WhiteMuyi/Timelapse-Photogrammetry-Wireless-Sensing-Network/figure/23.jpg

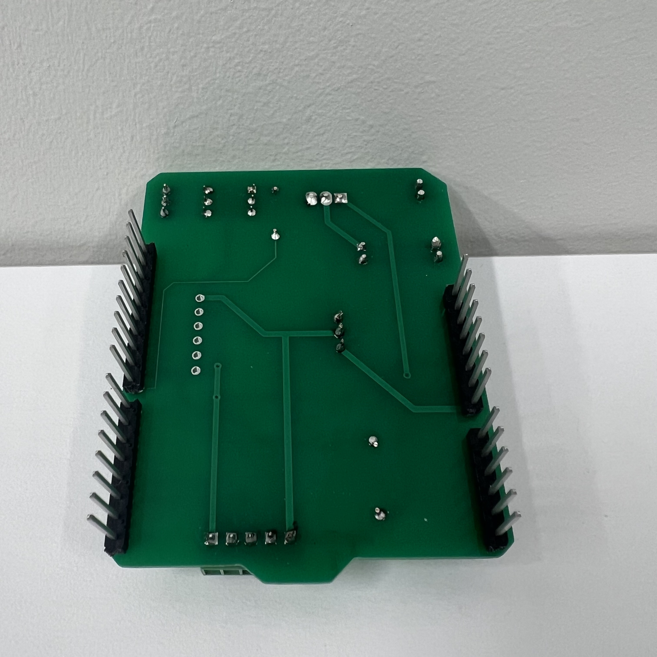
figure/23.jpg
