WhiteMuyi/Timelapse-Photogrammetry-Wireless-Sensing-Network/figure/27.jpg

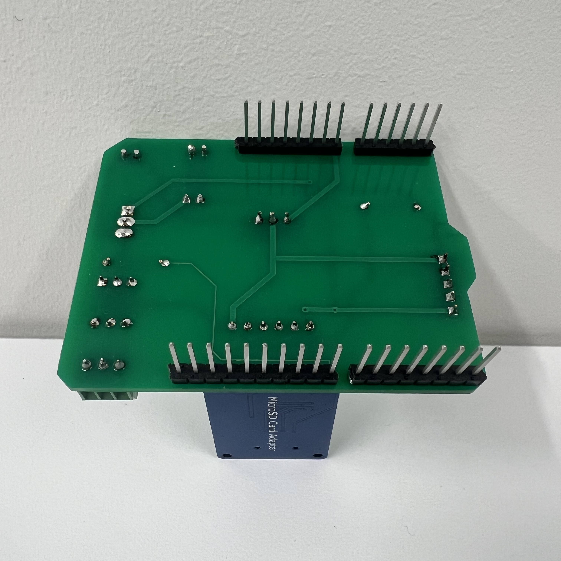
figure/27.jpg
