WhiteMuyi/Timelapse-Photogrammetry-Wireless-Sensing-Network/Tutorial/CaseInstall.md

### Inside & Outside Install:

Inside             |  Outside
:-------------------------:|:-------------------------:
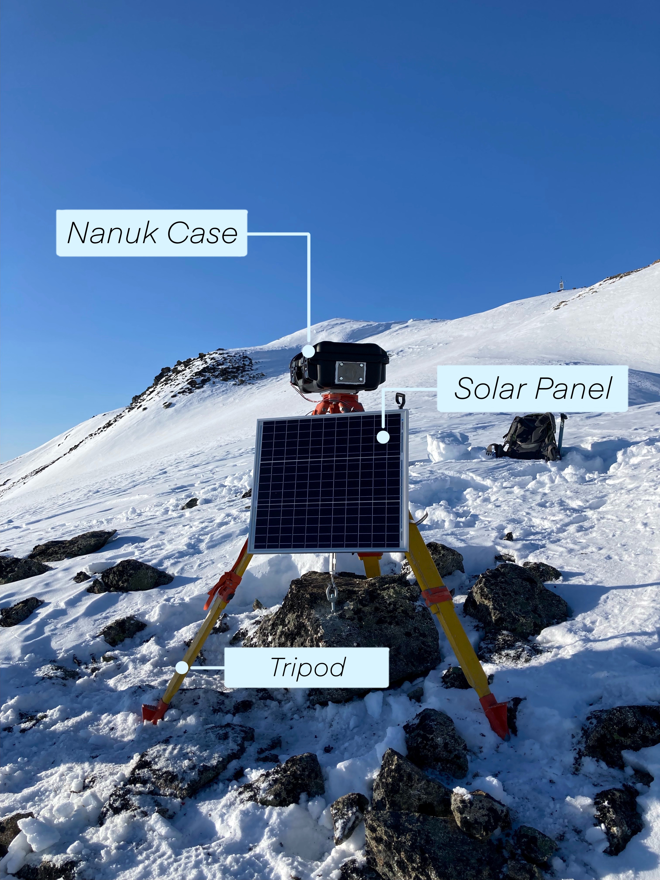
[picture p11: figure/Outside.jpg]
  |  

### Enclosure Detail:

Close-up of camera lens          |  Close-up of plexiglass      
:-------------------------:|:-------------------------:
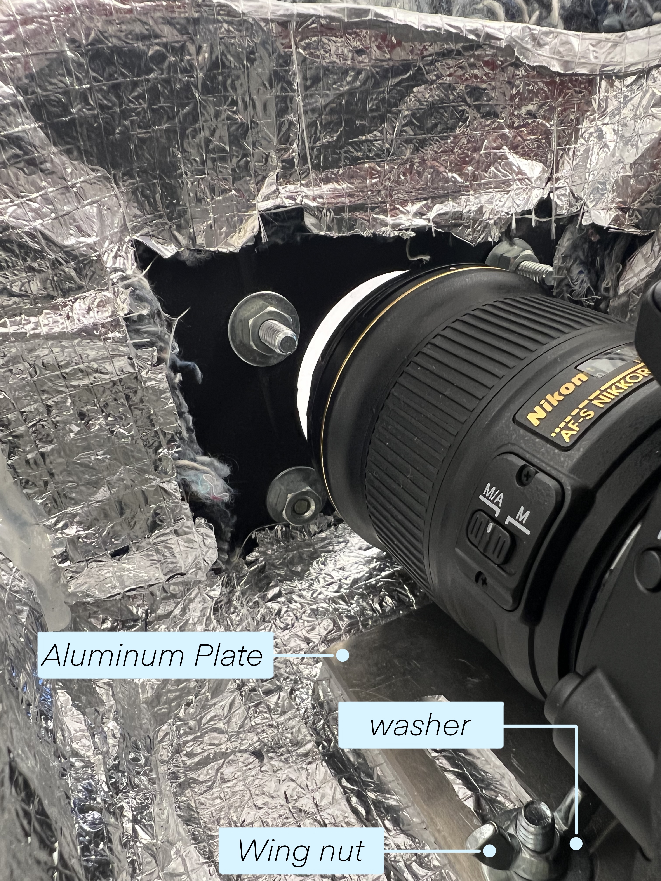
[picture p12: figure/Detail1.jpg]
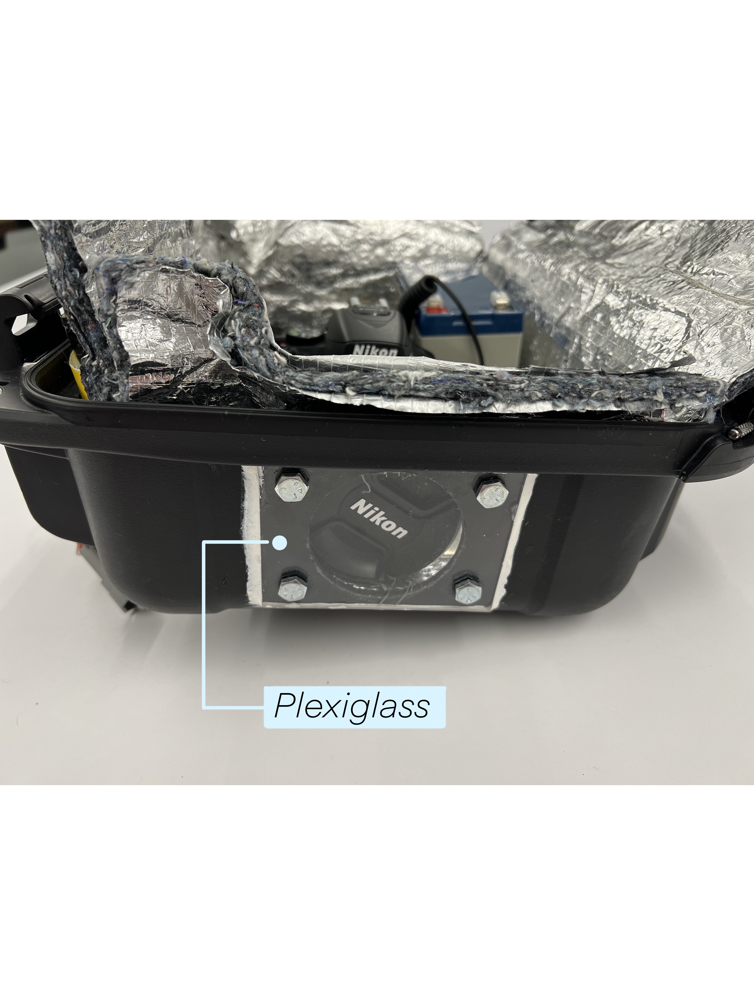
[picture p13: figure/Detail2.jpg]
  |  

Close-up of cable gland      |  Close-up of Miscellaneous
:-------------------------:|:-------------------------:
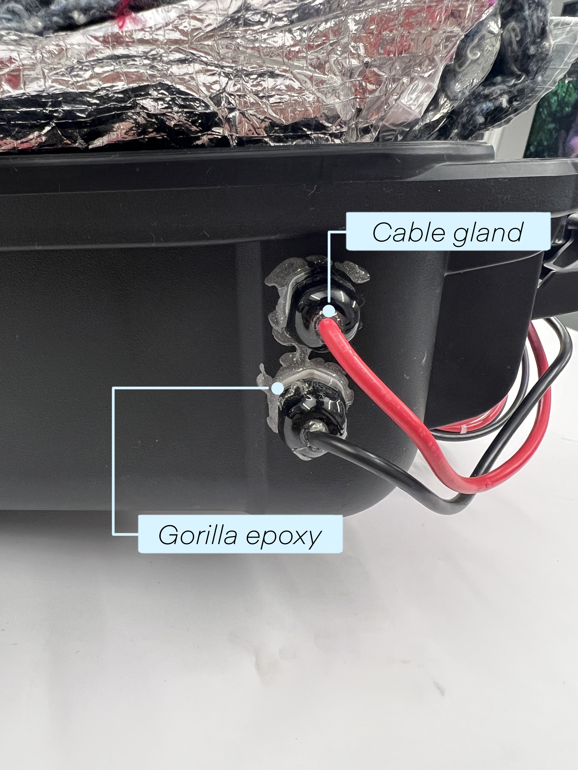
[picture p14: figure/Detail3.jpg]
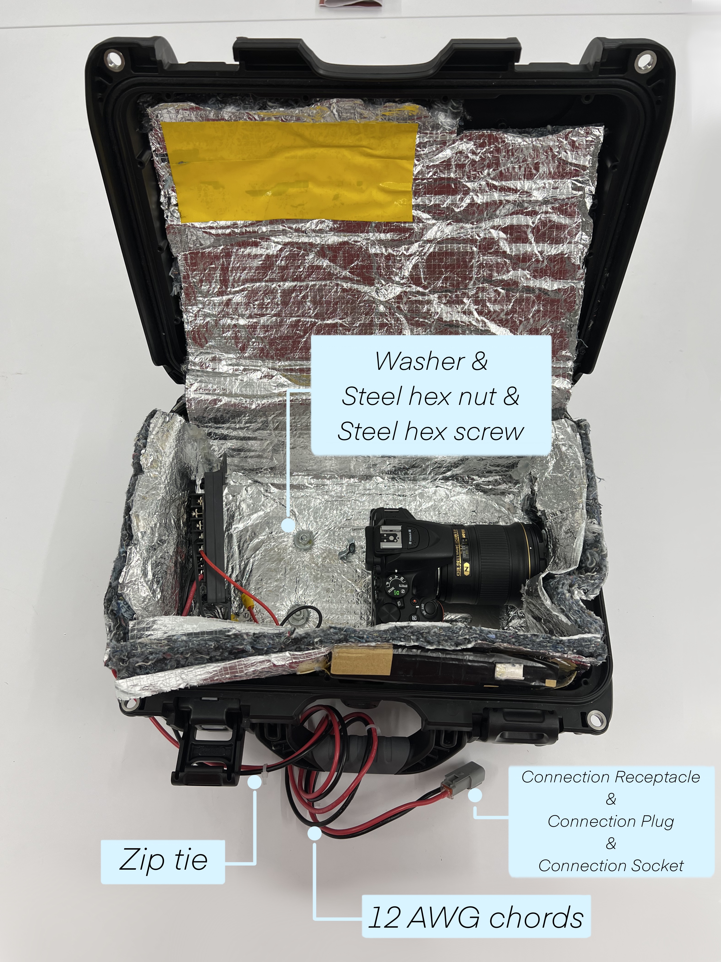
[picture p15: figure/Detail4.jpg]
|
