WhiteMuyi/Timelapse-Photogrammetry-Wireless-Sensing-Network/Tutorial/Step-by-Step.md

## Step-by-Step Soldering Tutorial

 The principle to be followed when soldering is to begin with the shorter components, followed by the taller ones.

### Step-1: 1kΩ resistance

Vertical             |  Bottom
:-------------------------:|:-------------------------:
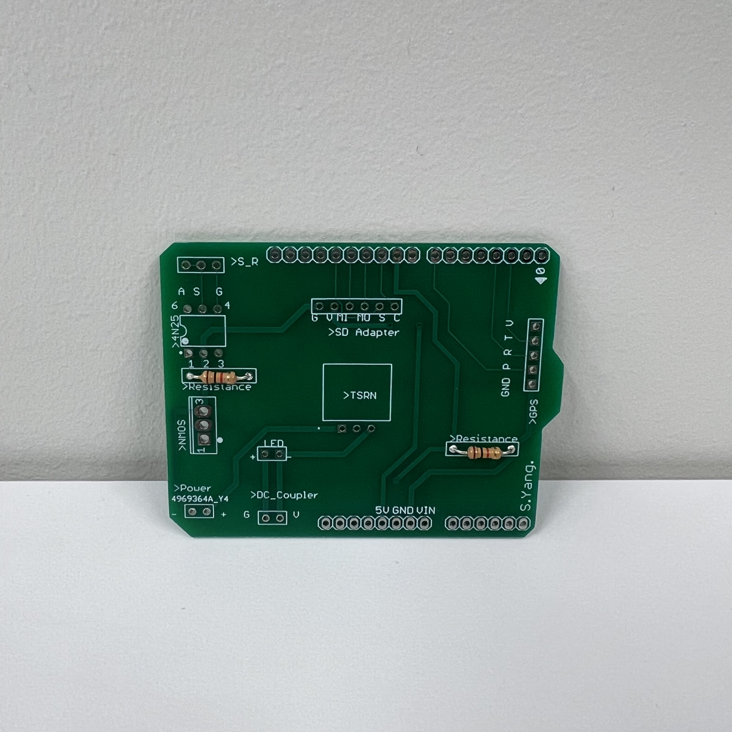
[picture p16: figure/1.jpg]
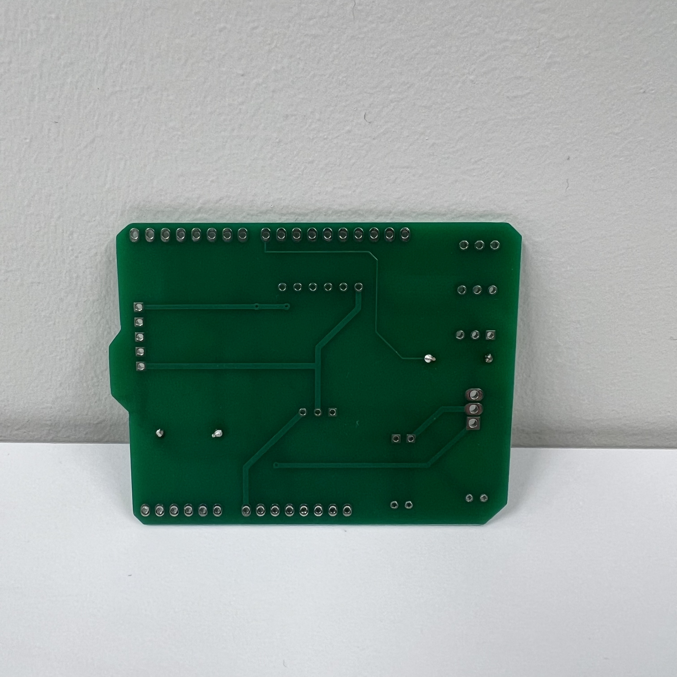
[picture p17: figure/2.jpg]
  |  

### Step-2: Optocoupler (4N25)

Vertical             |  Bottom
:-------------------------:|:-------------------------:
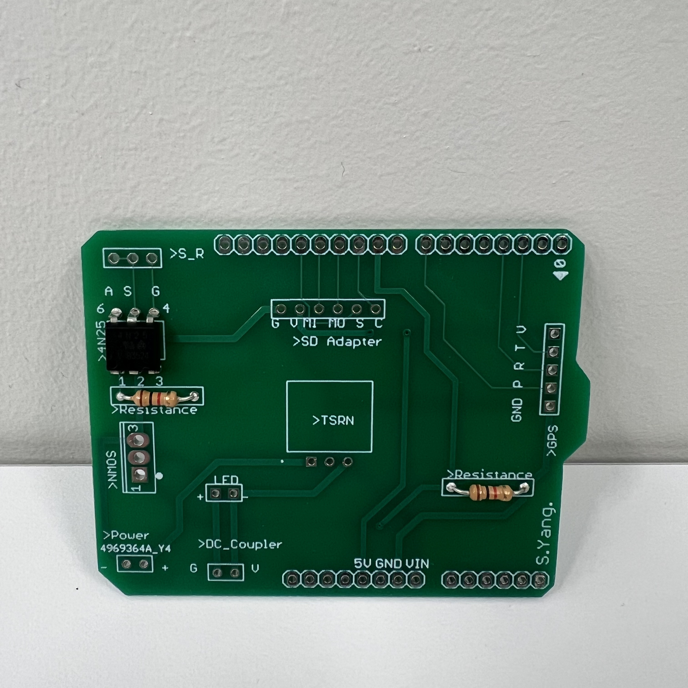
[picture p18: figure/3.jpg]
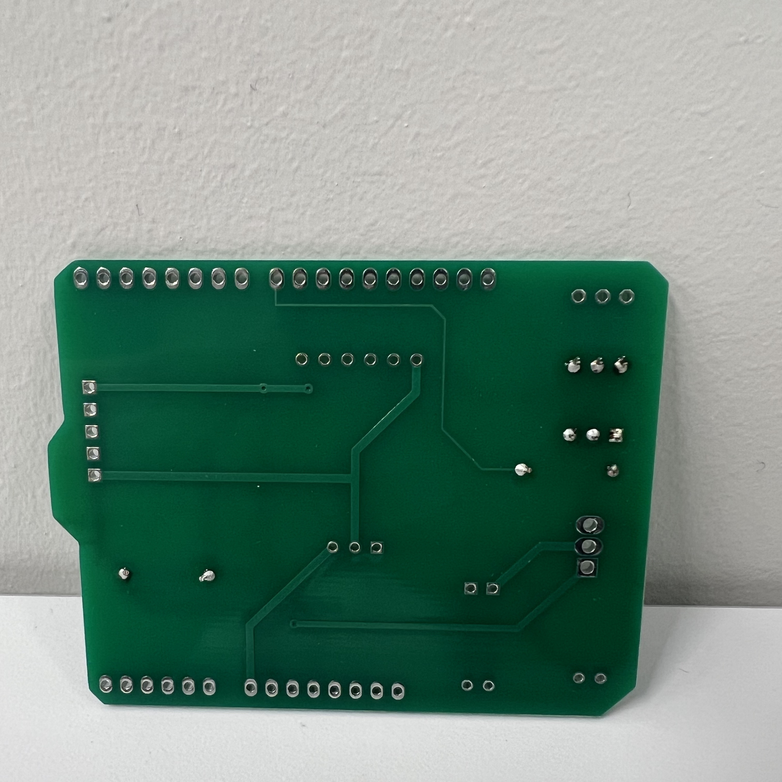
[picture p19: figure/4.jpg]
  |  

### Step-3: LED

Front             |  Vertical      |  Bottom
:-------------------------:|:-------------------------:|:-------------------------:
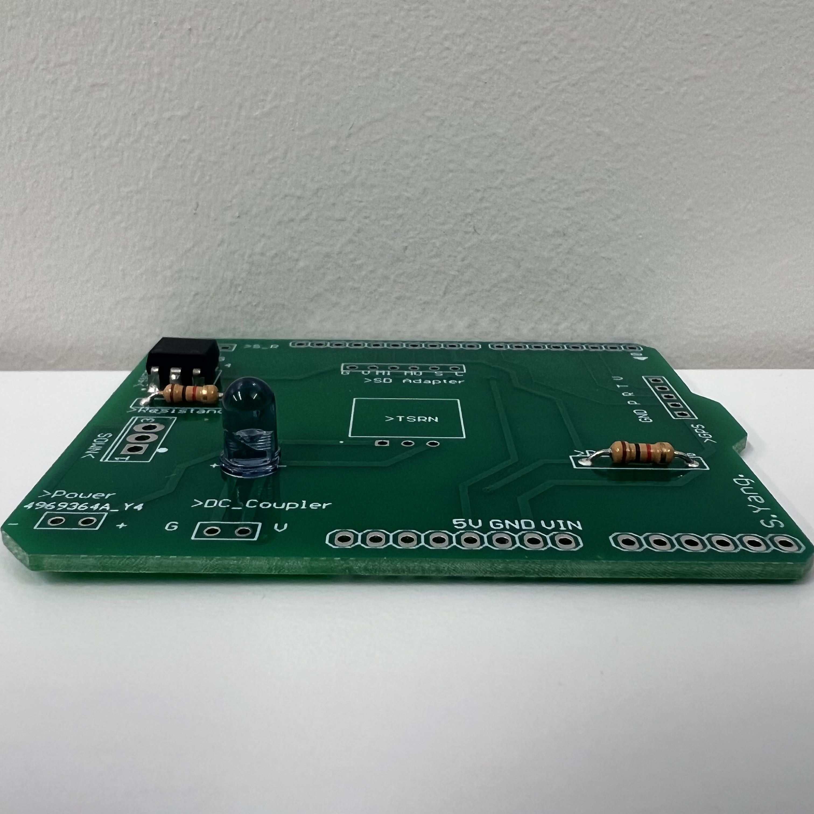
[picture p20: figure/5.jpg]
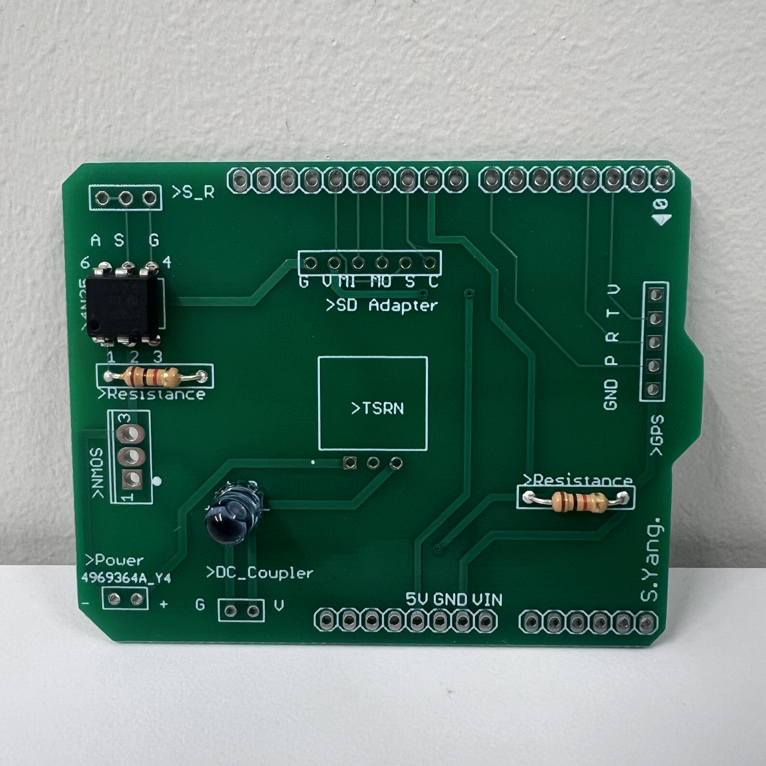
[picture p21: figure/6.jpg]
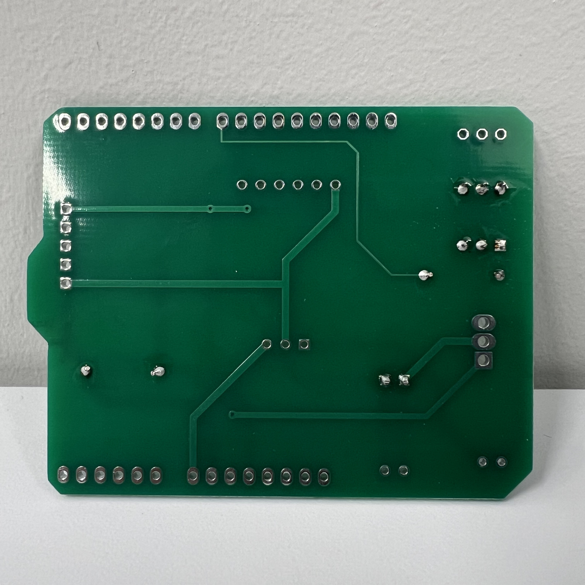
[picture p22: figure/7.jpg]
  |  |  

### Step-4: Terminal Block

3 x 2-pin terminal blocks and 2 x 3-pin terminal blocks are soldered in this step. 
The terminal blocks are for GPS, DC Coupler and Power.
The front of the terminal block should face outward towards the PCB.

Vertical                  |  Front                     |  Right                    |  Back                    |  Bottom
:-------------------------:|:-------------------------:|:-------------------------:|:-------------------------:|:-------------------------:
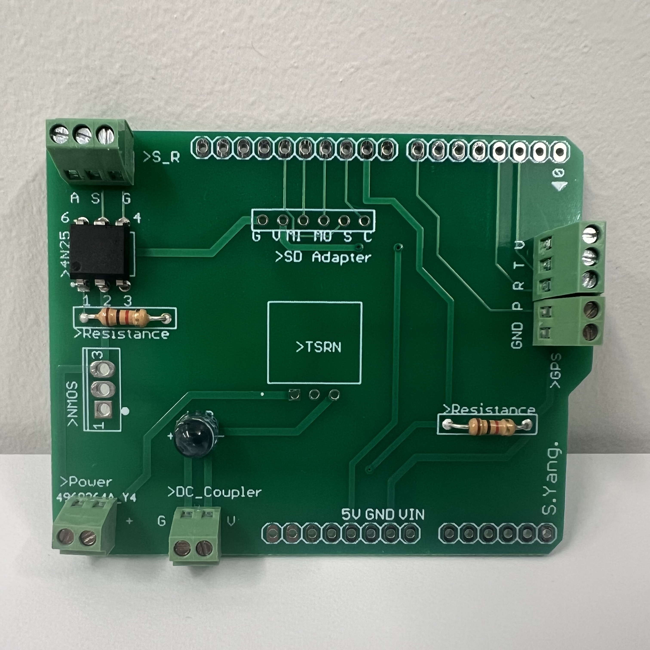
[picture p23: figure/8.jpg]
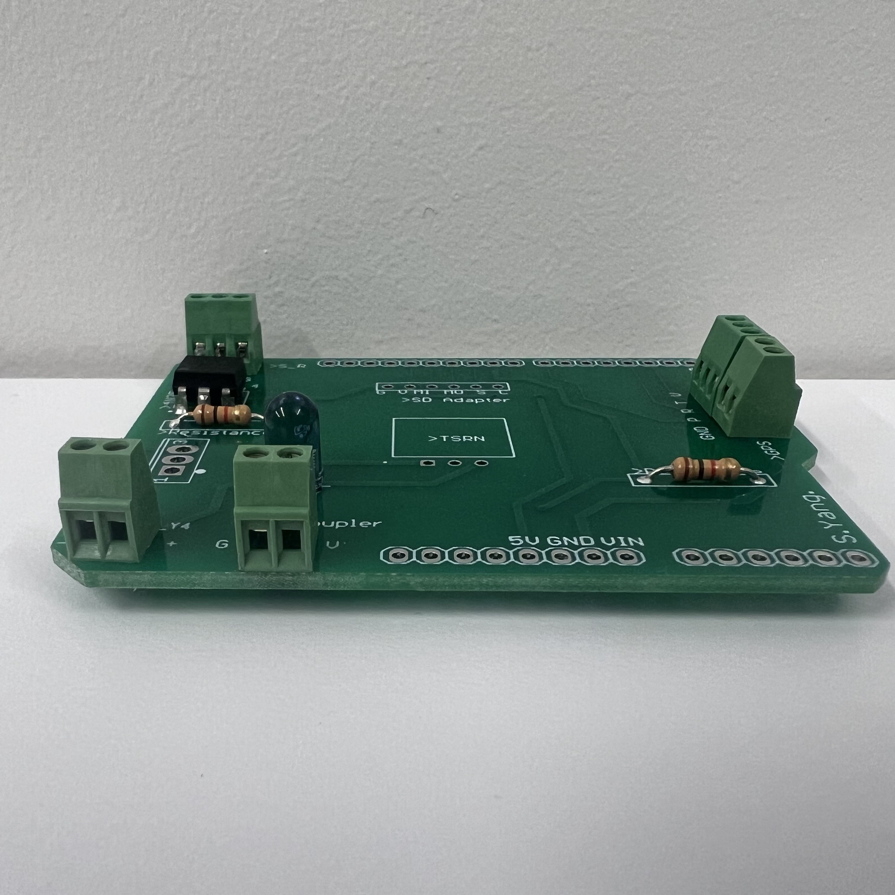
[picture p24: figure/9.jpg]
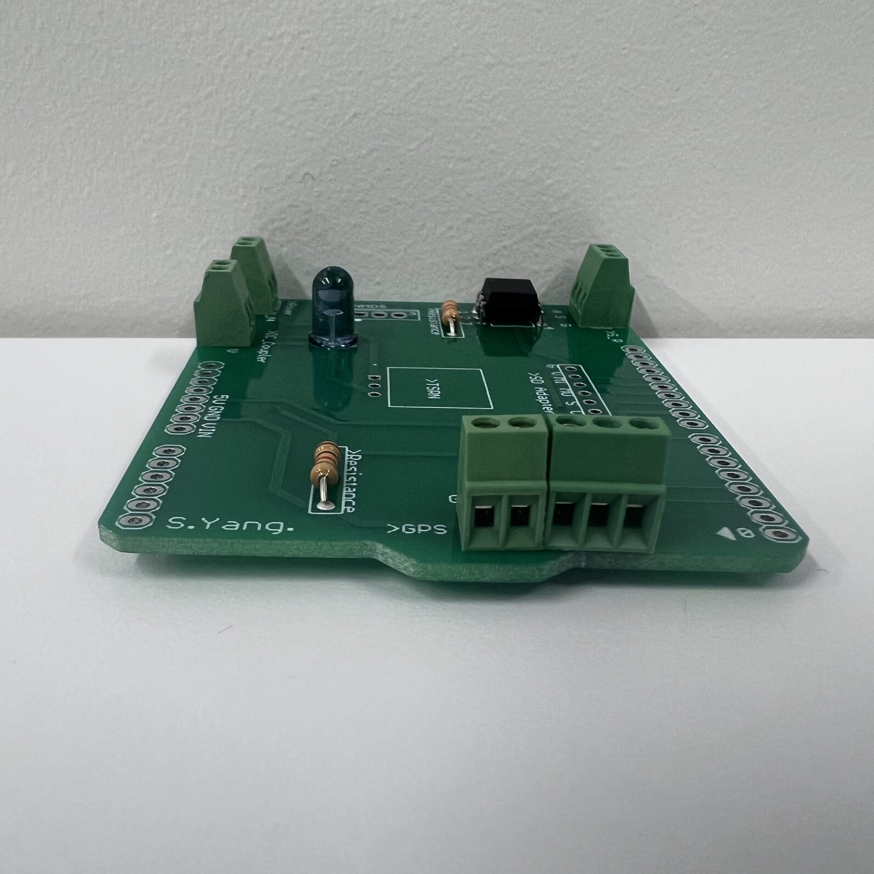
[picture p25: figure/10.jpg]
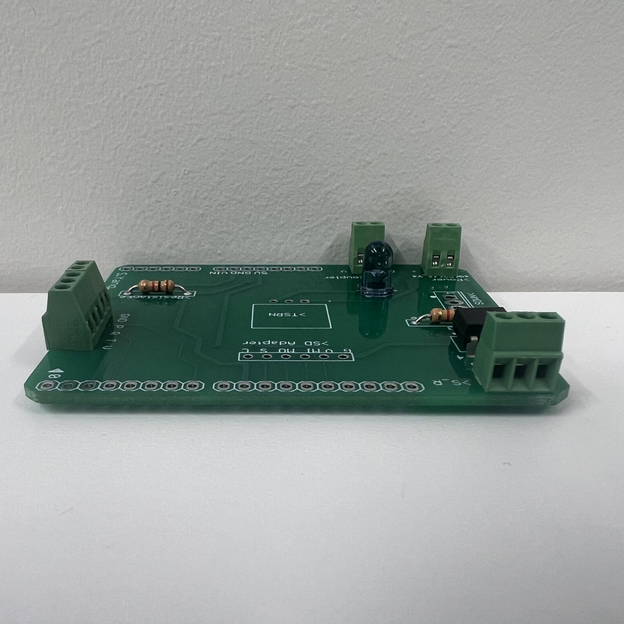
[picture p26: figure/11.jpg]
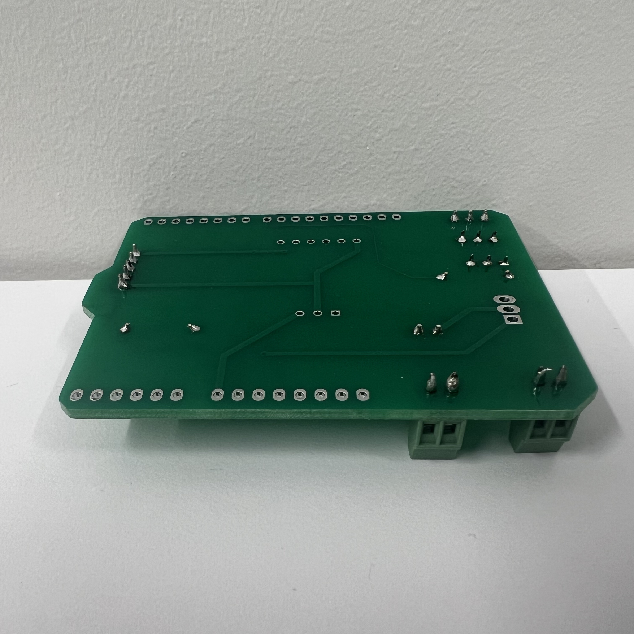
[picture p27: figure/12.jpg]
  |  |  |  |  

### Step-5: DC Converter 

Vertical             |  Bottom
:-------------------------:|:-------------------------:
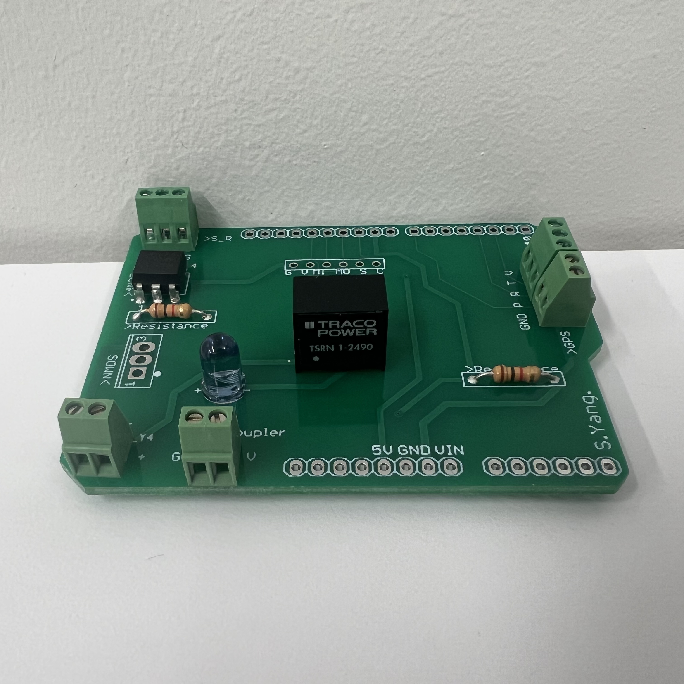
[picture p28: figure/13.jpg]
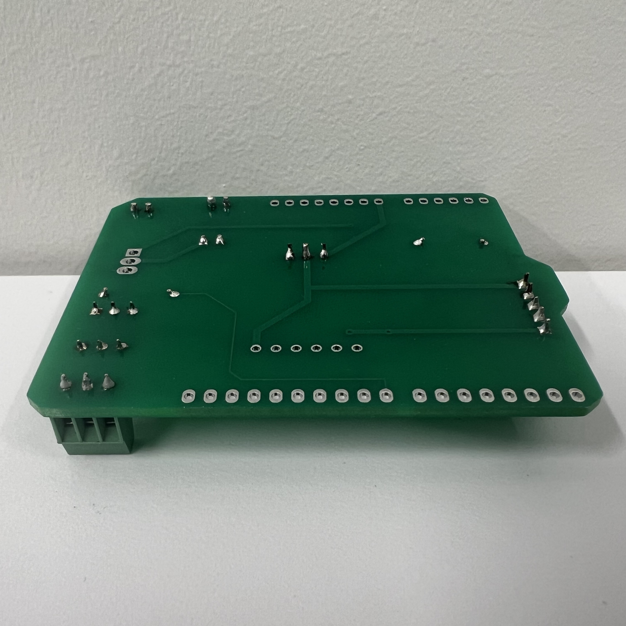
[picture p29: figure/14.jpg]
  |  

### Step-6: Header

Solder the header on PCB to connect Arduino. My suggesstion is to stick the headers on the Arduino, and solder PCB based on it. 
To connect the Arduino to the PCB, solder the header onto the PCB. One way to do this is to attach the header to the Arduino first and then solder the PCB based on that configuration. Additionally, it is advisable to use a non-functional Arduino for this purpose.

PCB with header before solder (with Arduino):

Vertical                   |  Front
:-------------------------:|:-------------------------:
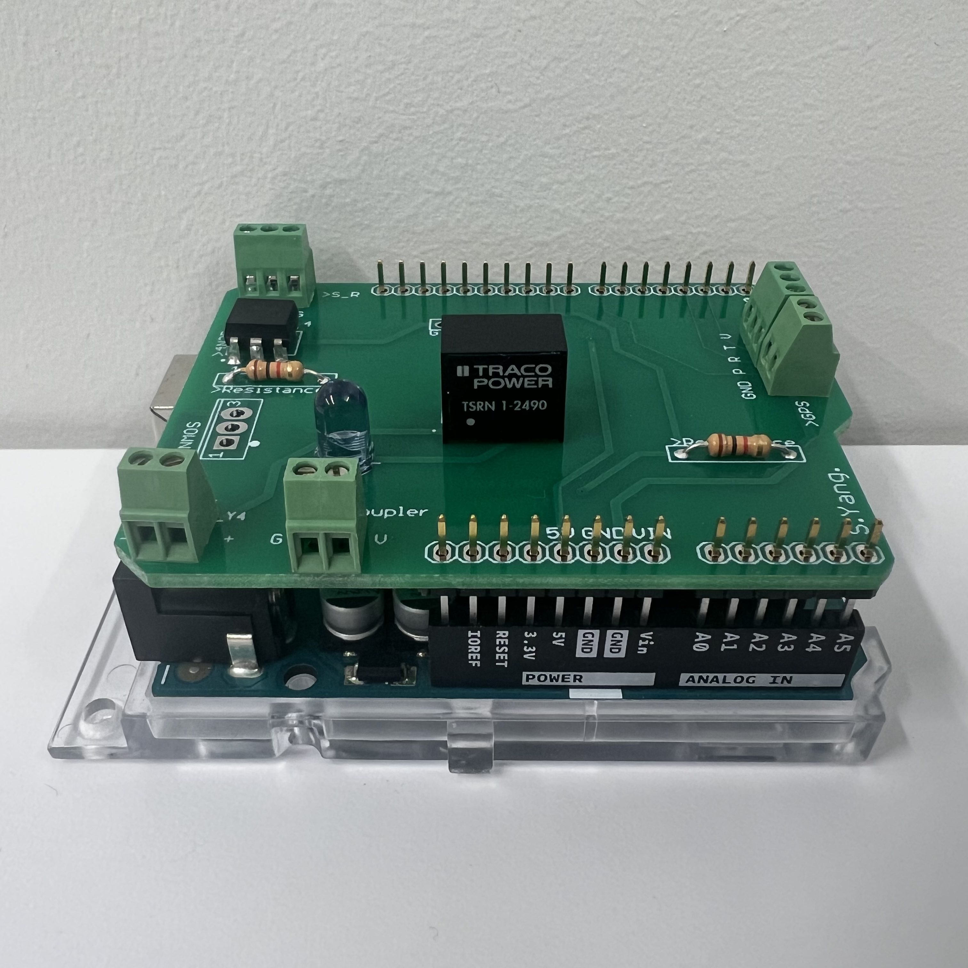
[picture p30: figure/15.jpg]
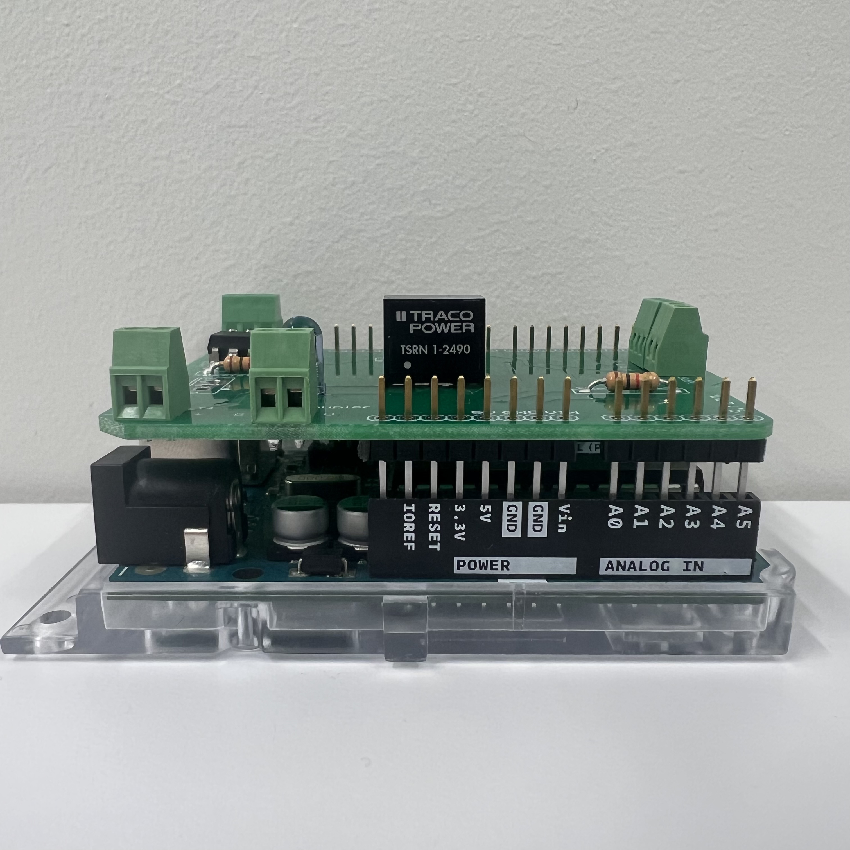
[picture p31: figure/16.jpg]
  |  

PCB with header after solder (with Arduino):

Front                   |  Back                       |  Vertical
:-------------------------:|:-------------------------:|:-------------------------:
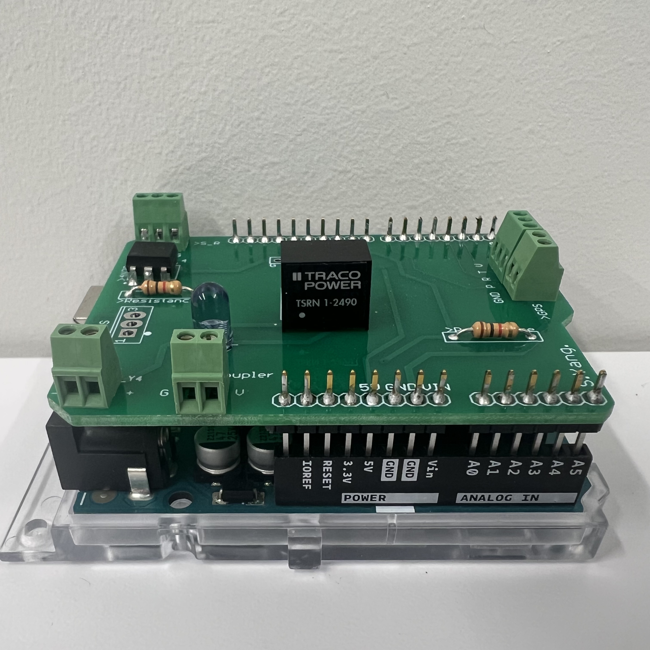
[picture p32: figure/17.jpg]
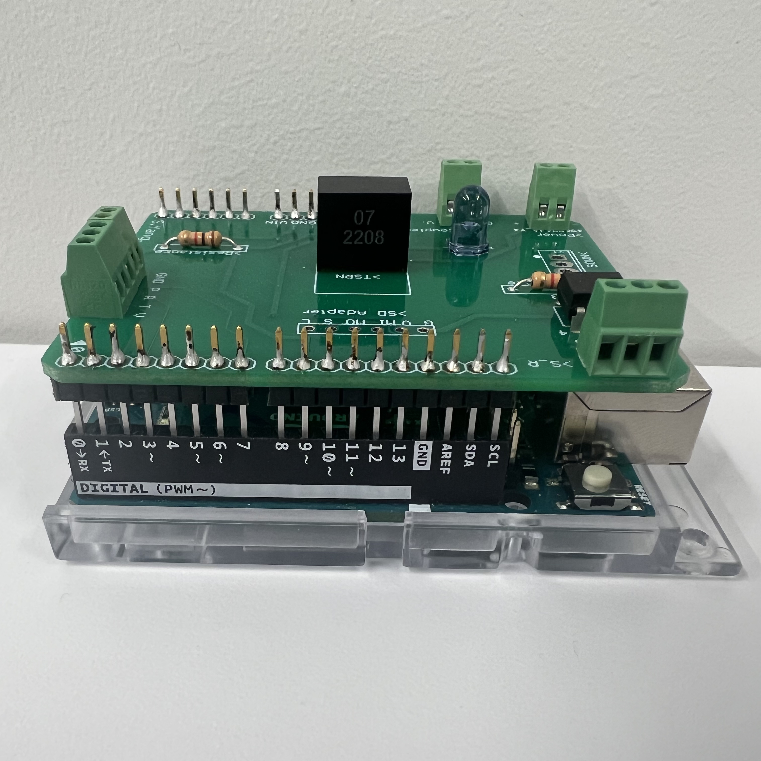
[picture p33: figure/18.jpg]
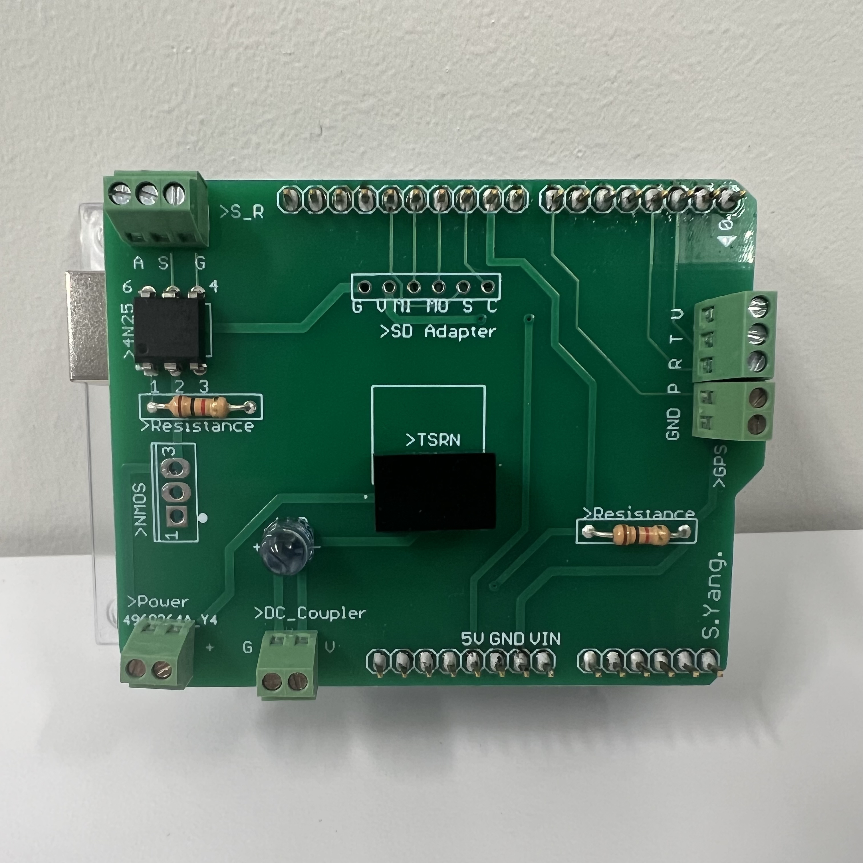
[picture p34: figure/19.jpg]
  |  |  

PCB with header after solder:

Front                   |  Bottom                       
:-------------------------:|:-------------------------:
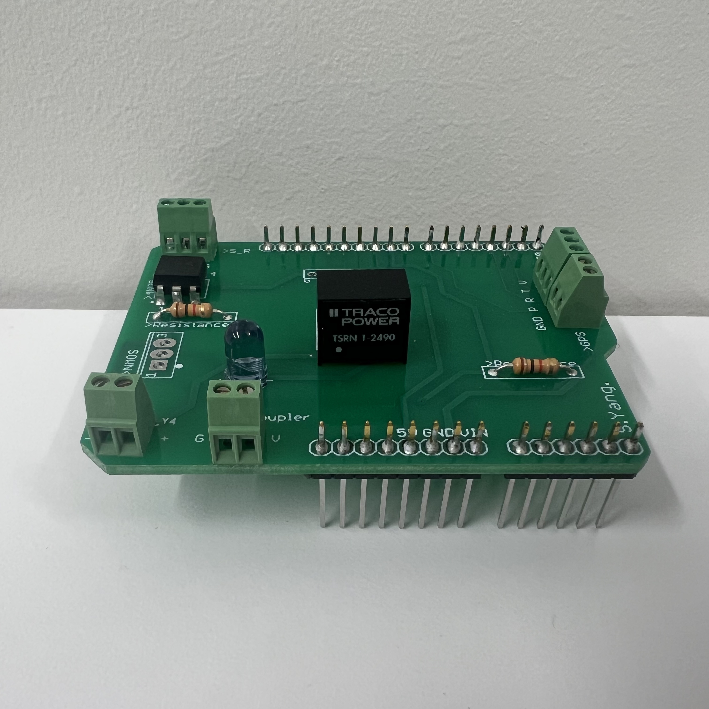
[picture p35: figure/20.jpg]
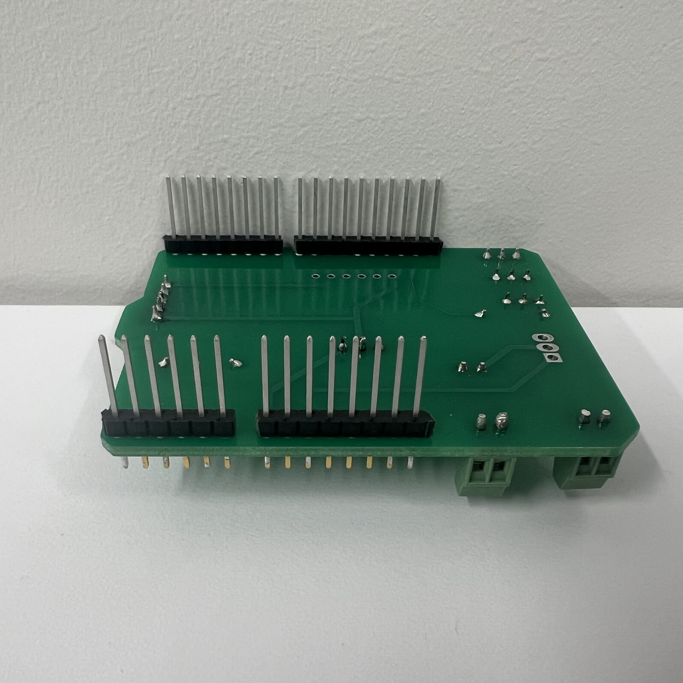
[picture p36: figure/21.jpg]
  |  

### Step-7: MOSFET

Front                   |  Bottom                       
:-------------------------:|:-------------------------:
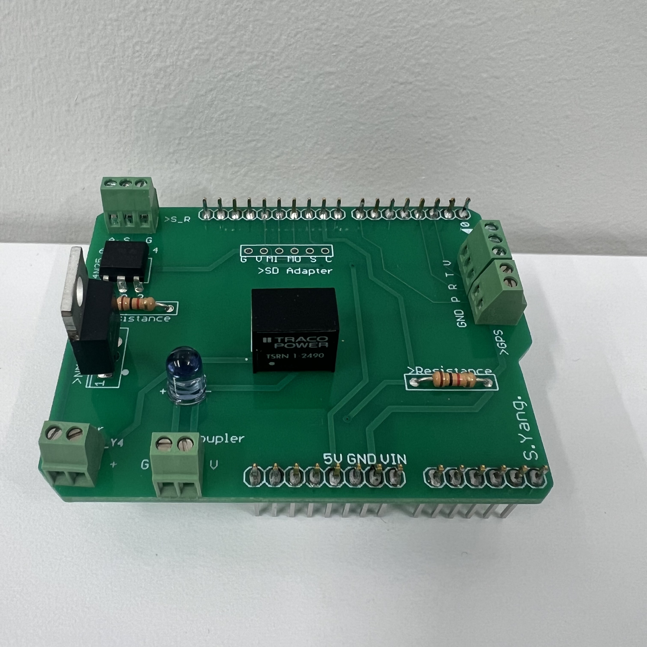
[picture p37: figure/22.jpg]
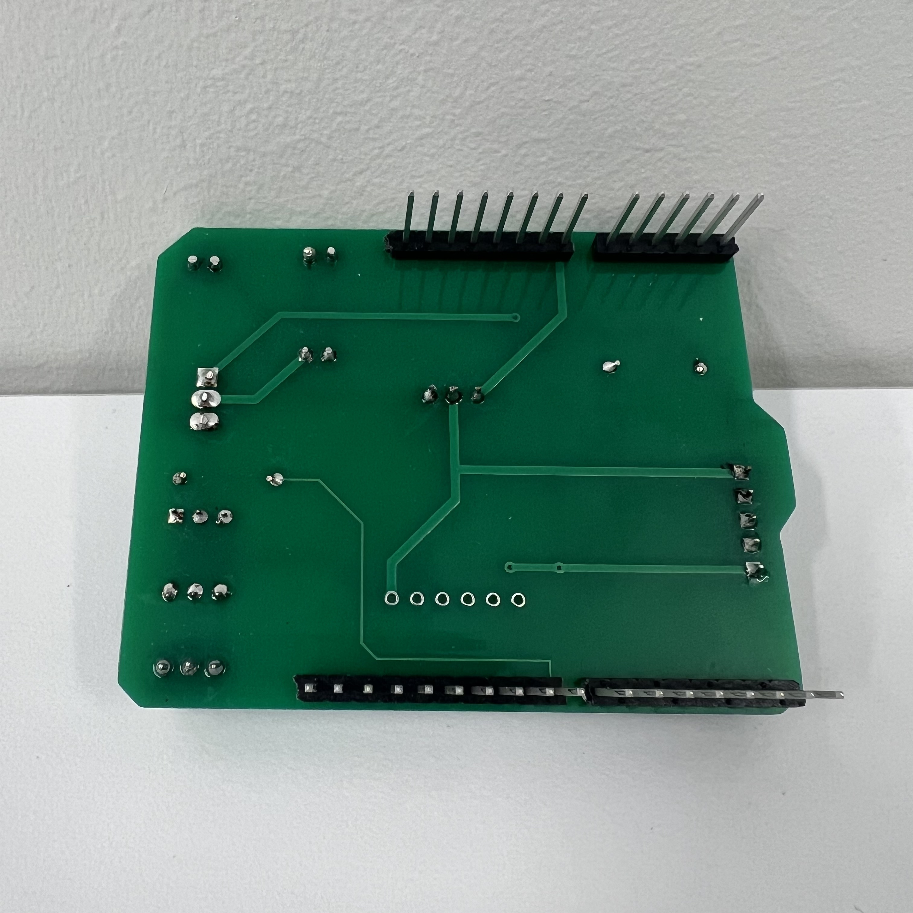
[picture p38: figure/24.jpg]
  |  

### Step-8: SD-Card Reader

Front                   |  Bottom                       
:-------------------------:|:-------------------------:
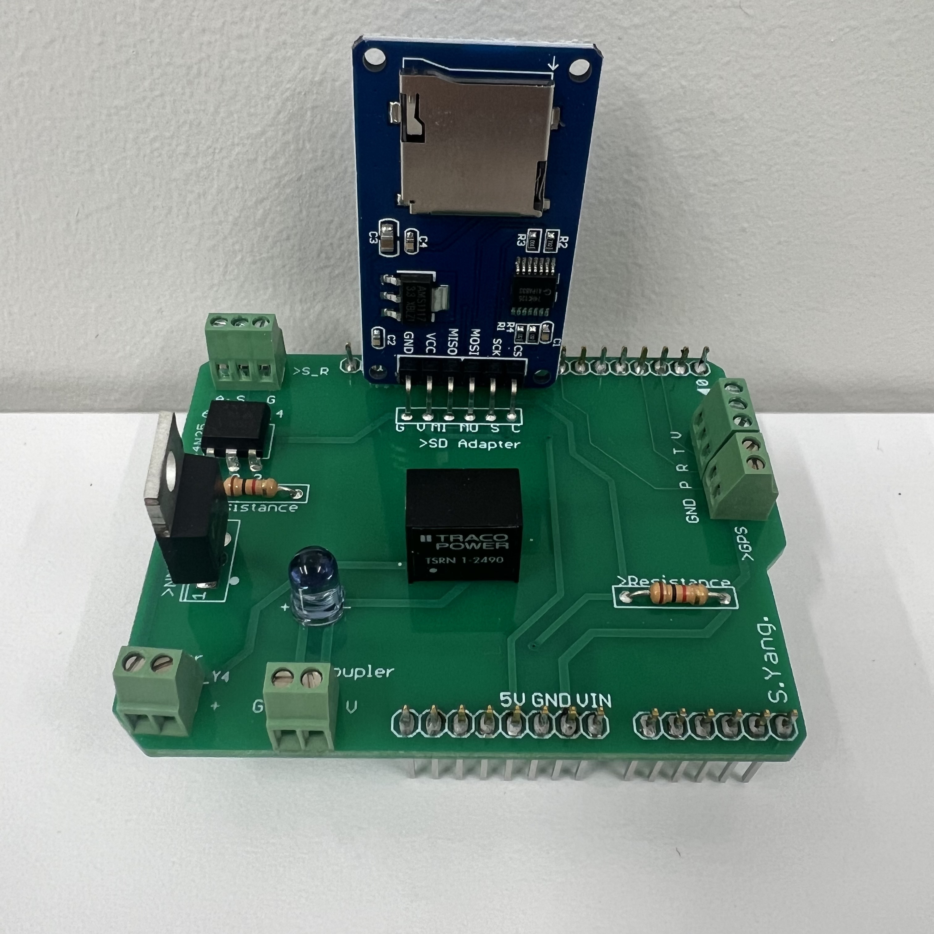
[picture p39: figure/25.jpg]
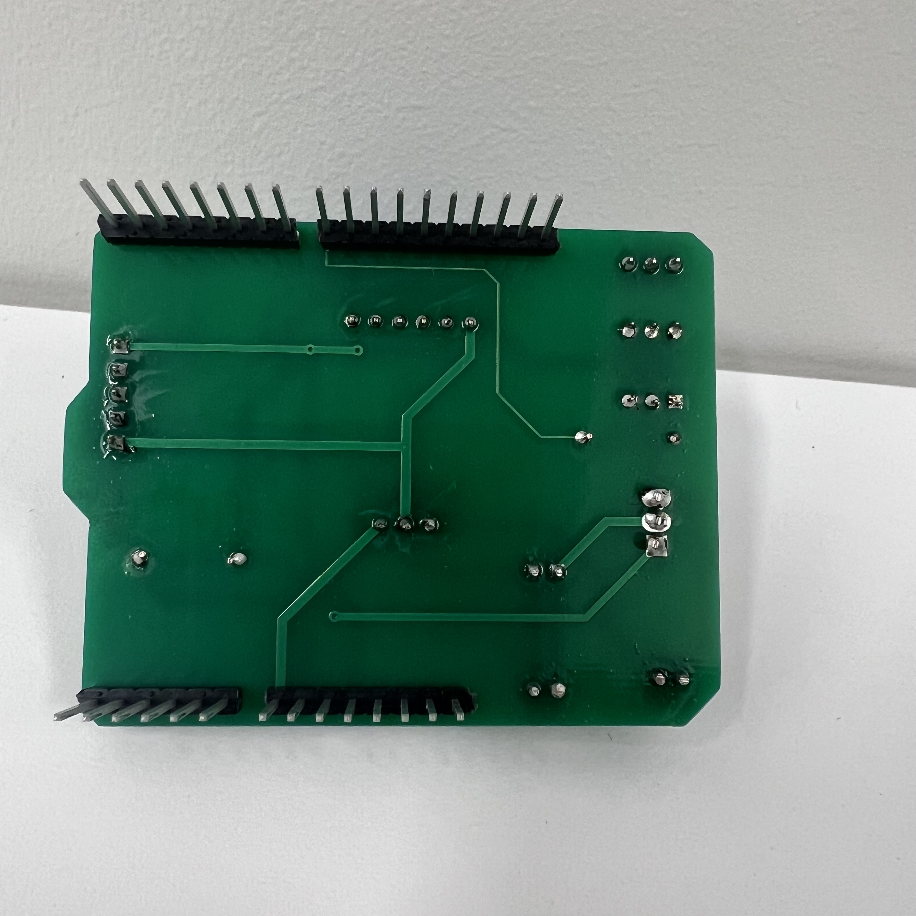
[picture p40: figure/26.jpg]
  |  

### Step-9: Wire Block

Front                   |  Right                       |  Back    
:-------------------------:|:-------------------------:|:-------------------------:
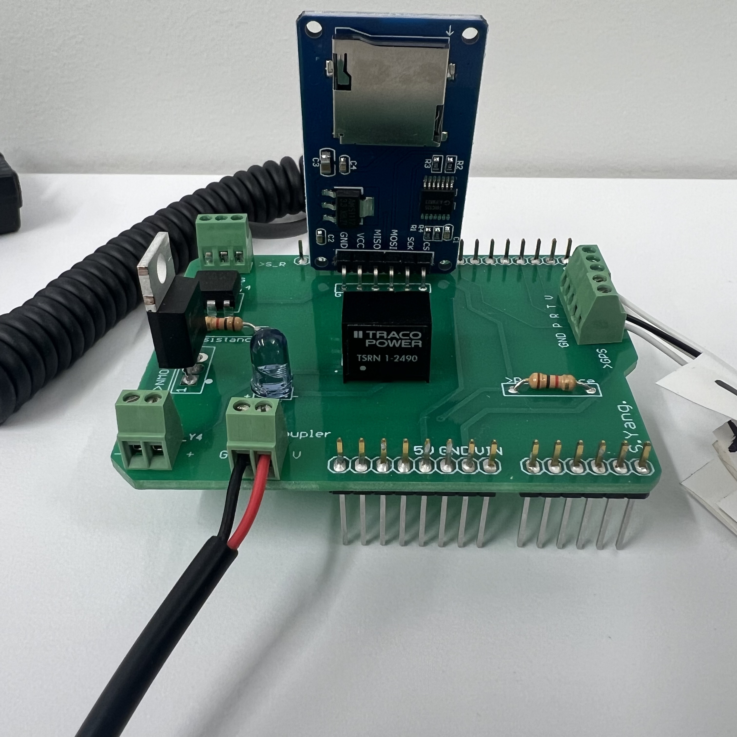
[picture p41: figure/28.jpg]
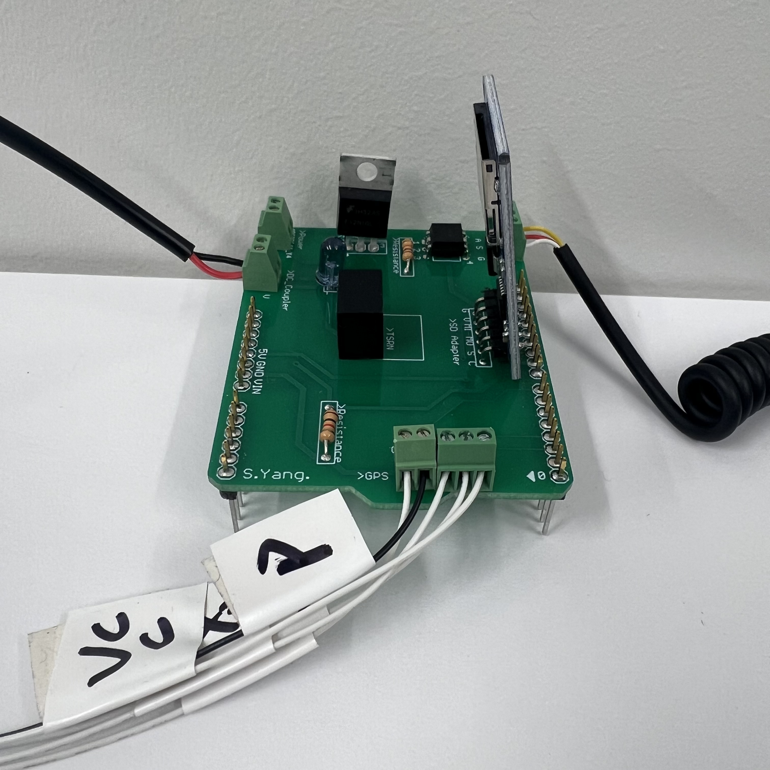
[picture p42: figure/29.jpg]
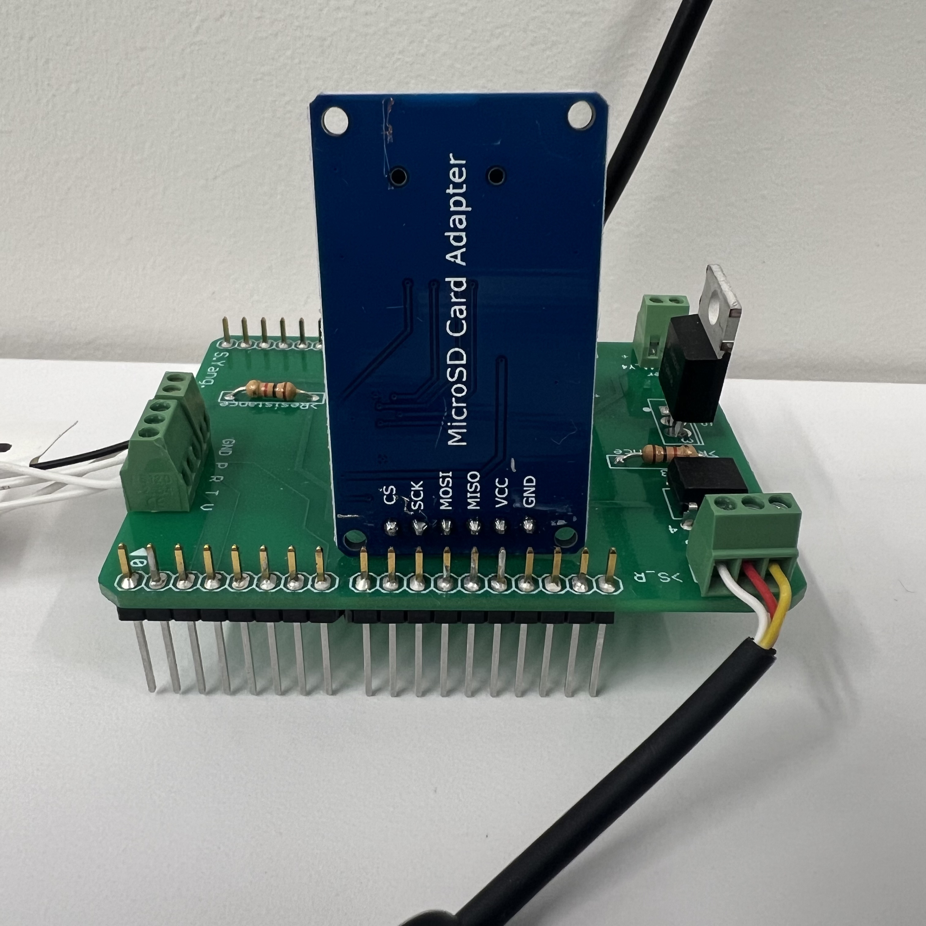
[picture p43: figure/30.jpg]
  |  |  

### Whole System with Camera & GPS:
